robosmoker/pcb/robosmoker.brd

## EAGLE design robosmoker.brd (2016-01-16)

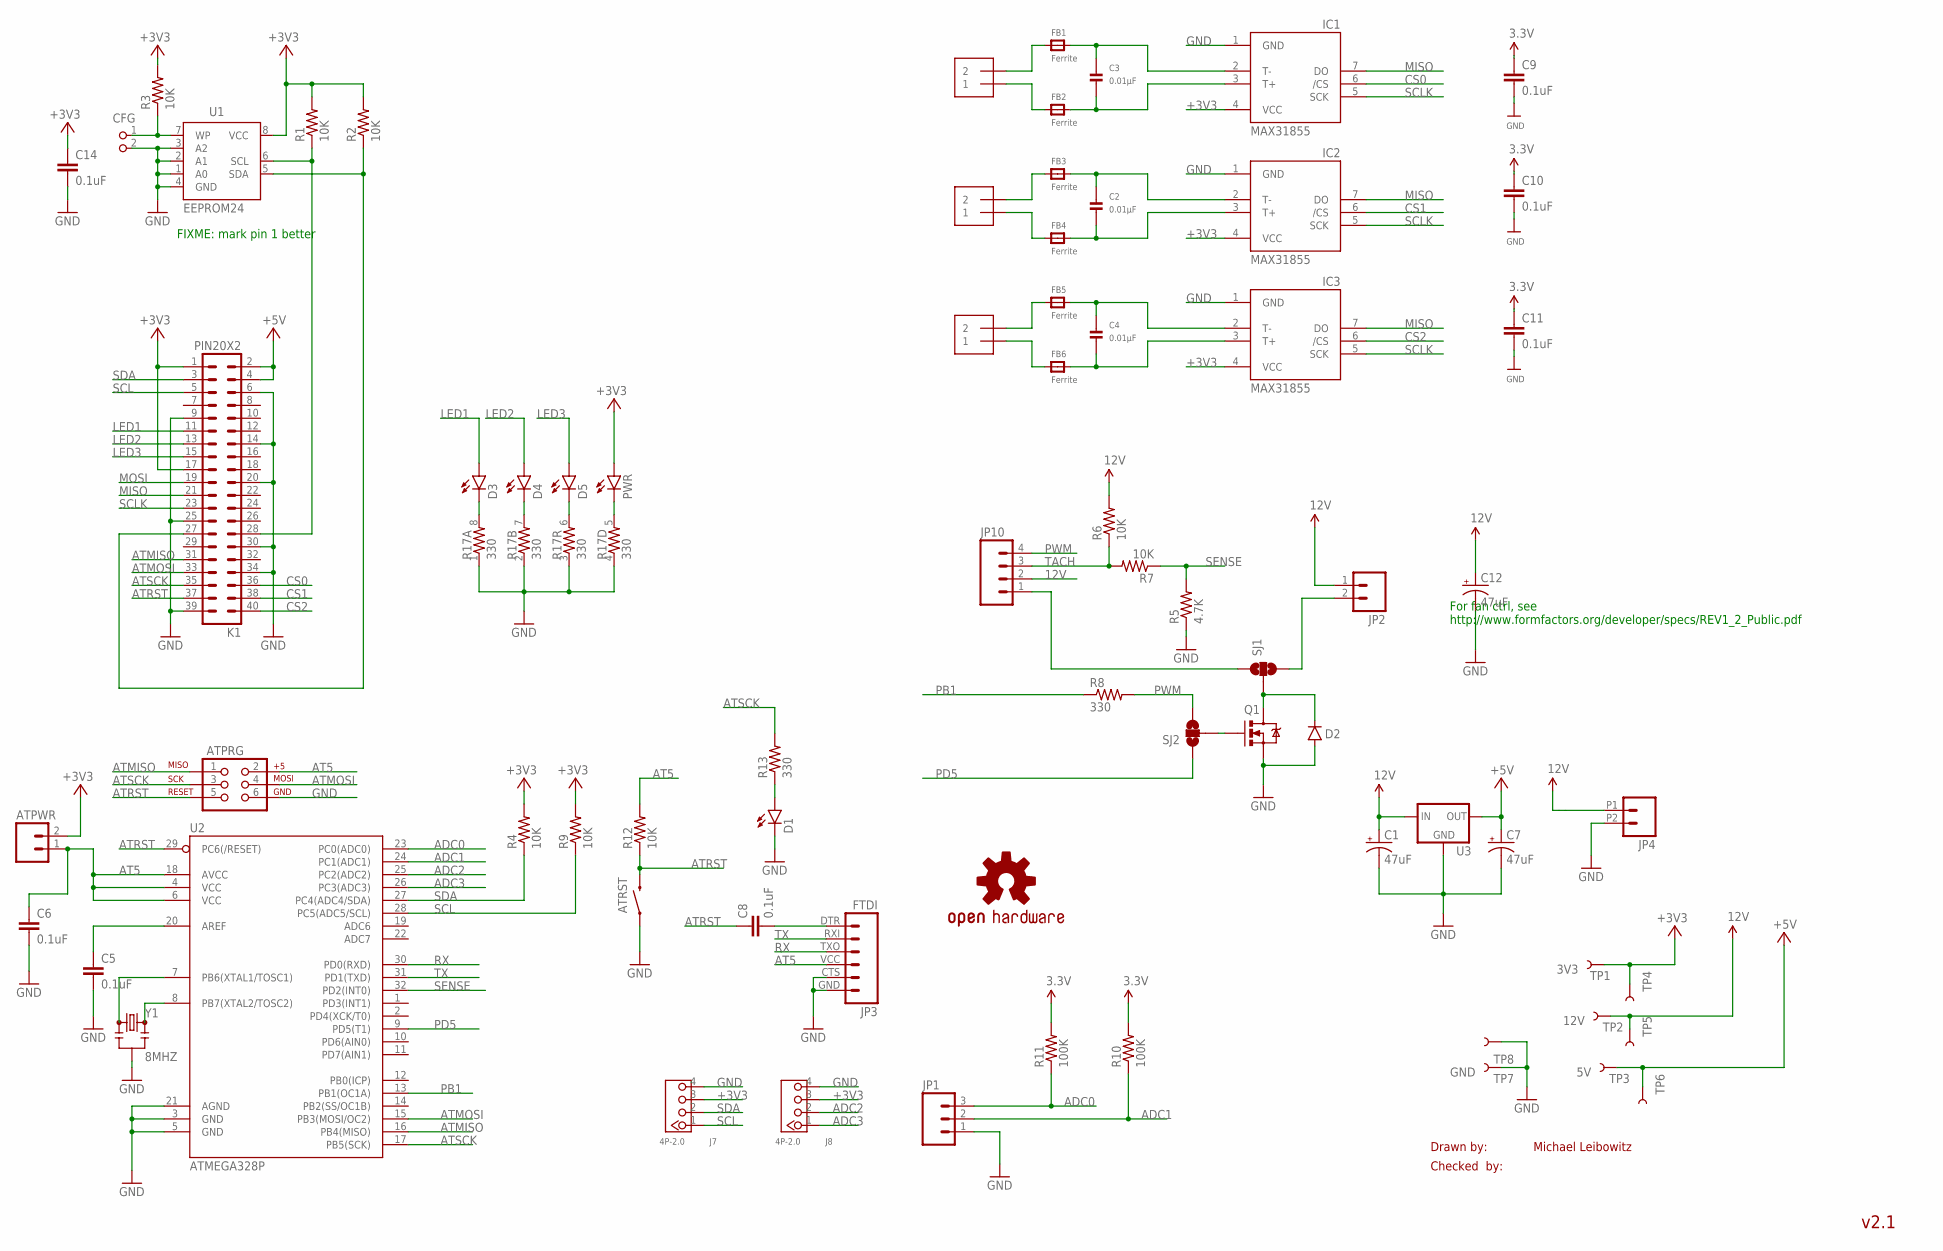
[picture p1: schematic robosmoker.sch]

Parts:
ATPRG: AVR_SPI_PRG_62X3_LOCK; 2X3_LOCK
ATPWR: M02LOCK; 1X02_LOCK
ATRST: SWITCH-MOMENTARY-2PTH; TACTILE-PTH
C1, C7, C12: 47uF; EIA7343
C2, C3, C4: 0.01µF; _0805
C5, C6, C8: 0.1uF; 0603-CAP
C9, C10, C11, C14: 0.1uF; 0805
CFG: PIN2_100; PIN_W_2
D1, D3, D4, D5: LED0603; LED-0603
D2: 250mA; SOD-323
FB1, FB2, FB3, FB4, FB5, FB6: Ferrite; _0805
IC1, IC2, IC3: MAX31855; SO08
J1, J2, J3: 1X2-3.5MM
J7, J8: 4P-2.0; HW4-2.0
JP1: M03SCREW; SCREWTERMINAL-3.5MM-3
JP2: M02POLAR_LOCK; MOLEX-1X2_LOCK
JP3: FTDI; FTDI_BASIC
JP4: M022.54MM_SCREWTERM; 1X02_2.54_SCREWTERM
JP10: M04POLAR_LOCK; MOLEX-1X4_LOCK
K1: PIN20X2; PIN_20X2
LOGO1: OSHW-LOGOM; OSHW-LOGO-M
PWR: LED0603; LED-0603
Q1: NFET-FDD8780; DPAK
R1, R2, R3, R4, R6, R7, R9, R12: 10K; 0603-RES
R5: 4.7K; 0603-RES
R8, R13: 330; 0603-RES
R10, R11: 100K; 0603-RES
R17: 330; 0603-ARV
SJ1, SJ2: SOLDERJUMPER_2WAYS; SJ_3
TP1: 3V3; PAD.03X.04
TP2: 12V; PAD.03X.04
TP3: 5V; PAD.03X.04
TP4, TP5, TP6, TP8: 3V3; TP_15TH
TP7: GND; PAD.03X.04
U1: EEPROM24; SOIC8
U2: ATMEGA328P; TQFP32-08
U3: V_REG_78XXSINK; TO220-IGO
Y1: 8MHZ; RESONATOR-SMD

Connections:
12V: C1.A (+), C12.A (+), JP2.1, JP4.P1 (1), JP10.2, R6.2, TP2.P$1, TP5.P$1, U3.IN
+3V3: ATPWR.2, C9.1, C10.1, C11.1, C14.1, IC1.4 (VCC), IC2.4 (VCC), IC3.4 (VCC), J7.3, J8.3, K1.1, K1.17, PWR.A, R1.2, R2.2, R3.2, R4.2, R9.2, R10.2, R11.2, TP1.P$1, TP4.P$1, U1.8 (VCC)
+5V: C7.A (+), K1.2, K1.4, TP3.P$1, TP6.P$1, U3.OUT
ADC0: JP1.3, R11.1, U2.23 (PC0(ADC0))
ADC1: JP1.2, R10.1, U2.24 (PC1(ADC1))
ADC2: J8.2, U2.25 (PC2(ADC2))
ADC3: J8.1, U2.26 (PC3(ADC3))
AT5: ATPRG.2, ATPWR.1, C6.1, JP3.VCC (4), R12.2, U2.4 (VCC), U2.6 (VCC), U2.18 (AVCC)
ATMISO: ATPRG.1, K1.31, U2.16 (PB4(MISO))
ATMOSI: ATPRG.4, K1.33, U2.15 (PB3(MOSI/OC2))
ATRST: ATPRG.5, ATRST.3 (2), C8.1, K1.37, R12.1, U2.29 (PC6(/RESET))
ATSCK: ATPRG.3, K1.35, R13.2, U2.17 (PB5(SCK))
CS0: IC1.6 (/CS), K1.36
CS1: IC2.6 (/CS), K1.38
CS2: IC3.6 (/CS), K1.40
GND: ATPRG.6, ATRST.1, C1.C (-), C5.2, C6.2, C7.C (-), C9.2, C10.2, C11.2, C12.C (-), C14.2, CFG.2, D1.C, D2.A, IC1.1 (GND), IC2.1 (GND), IC3.1 (GND), J7.4, J8.4, JP1.1, JP3.CTS (5), JP3.GND (6), JP4.P2 (2), K1.6, K1.9, K1.14, K1.20, K1.25, K1.30, K1.34, K1.39, Q1.3 (S), R5.1, R17.1, R17.2 (1), R17.3 (1), R17.4 (1), TP7.P$1, TP8.P$1, U1.1 (A0), U1.2 (A1), U1.3 (A2), U1.4 (GND), U2.3 (GND), U2.5 (GND), U2.21 (AGND), U3.GND, Y1.2
LED1: D3.A, K1.11
LED2: D4.A, K1.13
LED3: D5.A, K1.15
MISO: IC1.7 (DO), IC2.7 (DO), IC3.7 (DO), K1.21
MOSI: K1.19
unnamed: K1.28, R1.1, U1.6 (SCL)
unnamed: K1.27, R2.1, U1.5 (SDA)
unnamed: CFG.1, R3.1, U1.7 (WP)
unnamed: FB1.1, J1.2
unnamed: C3.1, FB1.2, IC1.2 (T-)
unnamed: FB2.1, J1.1
unnamed: C3.2, FB2.2, IC1.3 (T+)
unnamed: FB3.1, J2.2
unnamed: C2.1, FB3.2, IC2.2 (T-)
unnamed: FB4.1, J2.1
unnamed: C2.2, FB4.2, IC2.3 (T+)
unnamed: FB5.1, J3.2
unnamed: C4.1, FB5.2, IC3.2 (T-)
unnamed: FB6.1, J3.1
unnamed: C4.2, FB6.2, IC3.3 (T+)
unnamed: JP2.2, SJ1.3
unnamed: JP10.1, SJ1.1
unnamed: C5.1, U2.20 (AREF)
unnamed: C8.2, JP3.DTR (1)
unnamed: D1.A, R13.1
unnamed: D3.C, R17.8 (2)
unnamed: D2.C, Q1.4 (D), SJ1.2
unnamed: D4.C, R17.7 (2)
unnamed: D5.C, R17.6 (2)
unnamed: Q1.1 (G), SJ2.2
unnamed: U2.7 (PB6(XTAL1/TOSC1)), Y1.1
unnamed: U2.8 (PB7(XTAL2/TOSC2)), Y1.3
PB1: R8.1, U2.13 (PB1(OC1A))
PD5: SJ2.1, U2.9 (PD5(T1))
PWM: JP10.4, R8.2, SJ2.3
PWR: PWR.C, R17.5 (2)
RX: JP3.TXO (3), U2.30 (PD0(RXD))
SCL: J7.1, K1.5, R9.1, U2.28 (PC5(ADC5/SCL))
SCLK: IC1.5 (SCK), IC2.5 (SCK), IC3.5 (SCK), K1.23
SDA: J7.2, K1.3, R4.1, U2.27 (PC4(ADC4/SDA))
SENSE: R5.2, R7.1, U2.32 (PD2(INT0))
TACH: JP10.3, R6.1, R7.2
TX: JP3.RXI (2), U2.31 (PD1(TXD))

Notes on the sheet:
Drawn by:
Checked by:
Michael Leibowitz
v2.1
For fan ctrl, see http://www.formfactors.org/developer/specs/REV1_2_Public.pdf
FIXME: mark pin 1 better

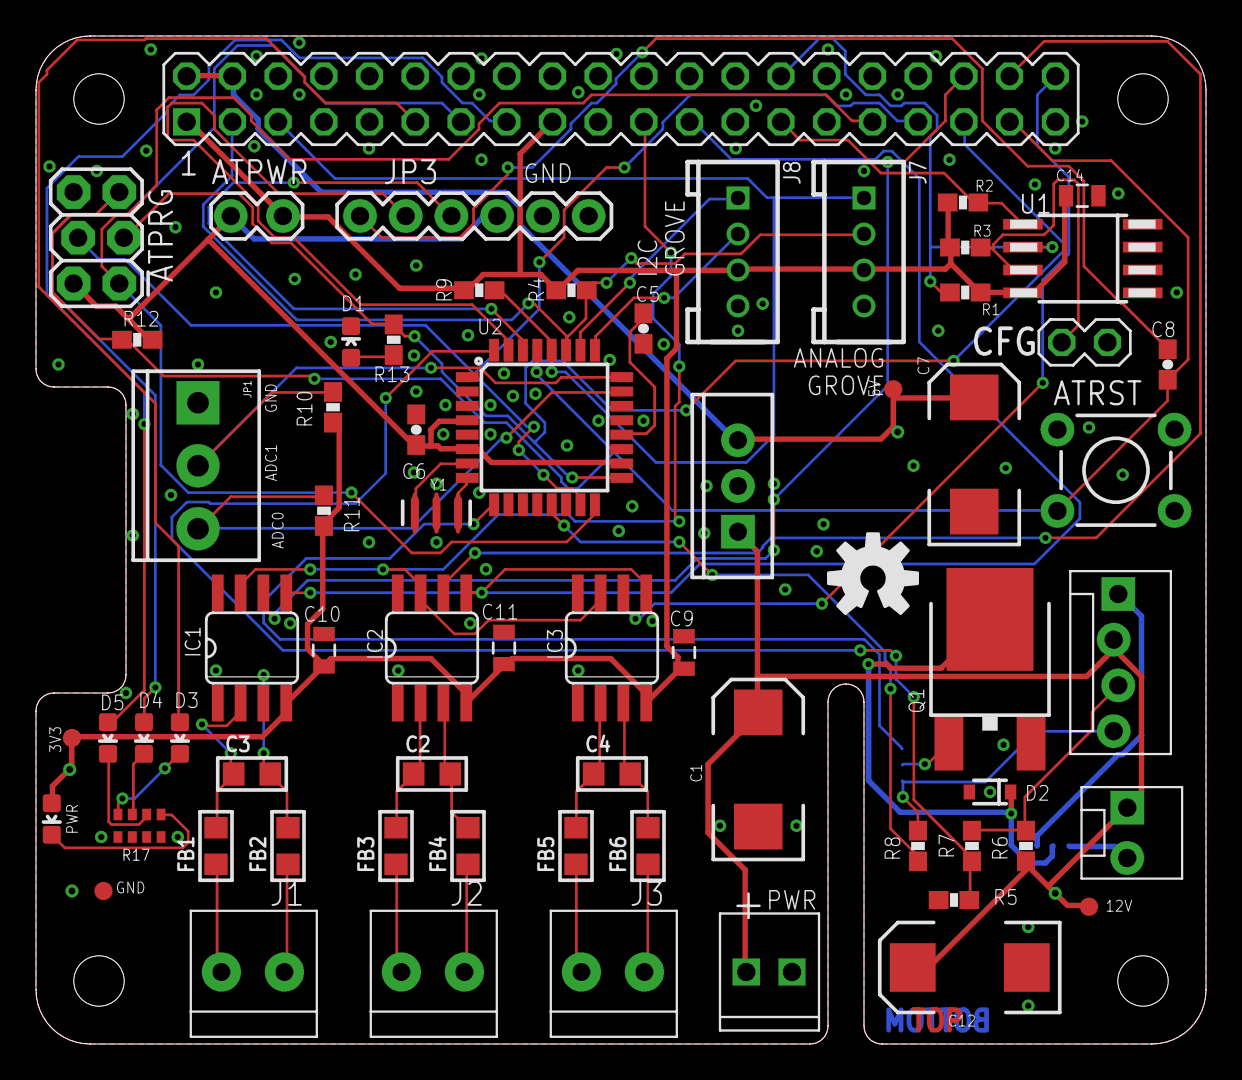
[picture p2: board robosmoker.brd from above]

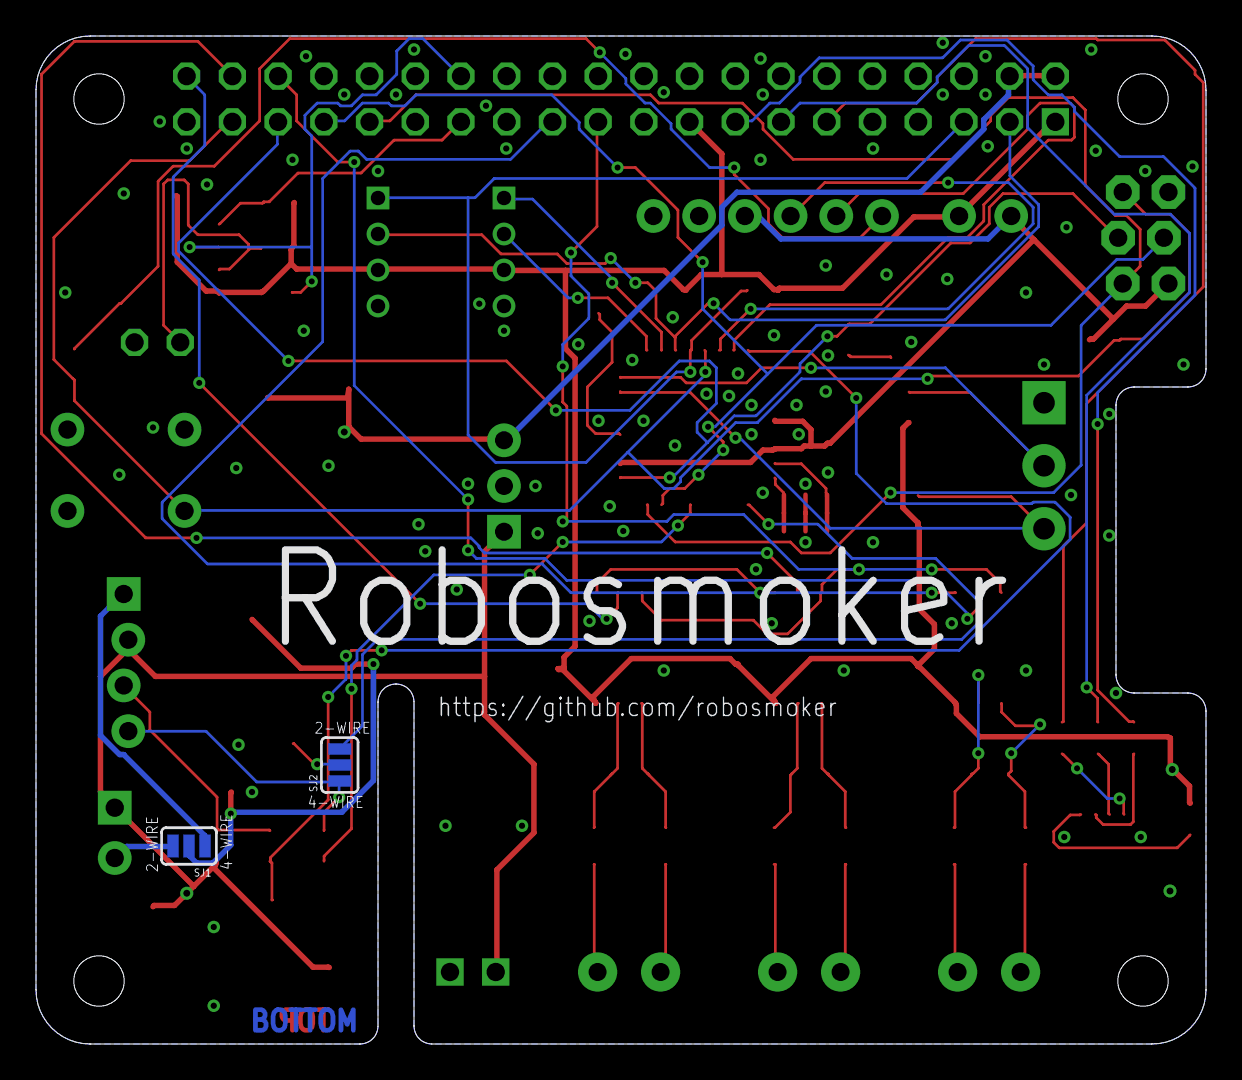
[picture p3: board robosmoker.brd from below]

Board: 2 copper layers, 65.0 x 56.0 mm, 73 parts (2 on the bottom side), 58 nets.
