robosmoker/pcb/(threads)

Thread 1 (2015-12-21):

unable to stop 4 wire fan

mikeleib, 2015-12-21:
Because 0 pwm is actually the minimum fan speed, 4-wire fans are unable to be stopped with current design.  Potential workaround would be to insert fet using one of grove connectors as switch on rail.

Thread 3 (2016-01-04):

adc voltage divider topology wrong

mikeleib, 2016-01-04:
output of pulldowns and analog input present on connector, but should be top-half of voltage divider joined to adc input and ground pairs
