robosmoker/pcb/(commit log)

2015-12-19 initial commit
    as sent to board house
    [RasPi-BplusHAT_CamSlot.brd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]
2016-01-01 some fixmes
    [RasPi-BplusHAT_CamSlot.sch]
2016-01-16 as sent to oshpark for rev2
    [RasPi-BplusHAT_CamSlot.brd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]
2016-01-16 tidying up things
    [robosmoker.brd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]
